ArnoudSerruys/GreenHouse/SmartGreenhouse/Smart Greenhouse.brd

## EAGLE design SmartGreenhouse/Smart Greenhouse.brd (2022-06-03)

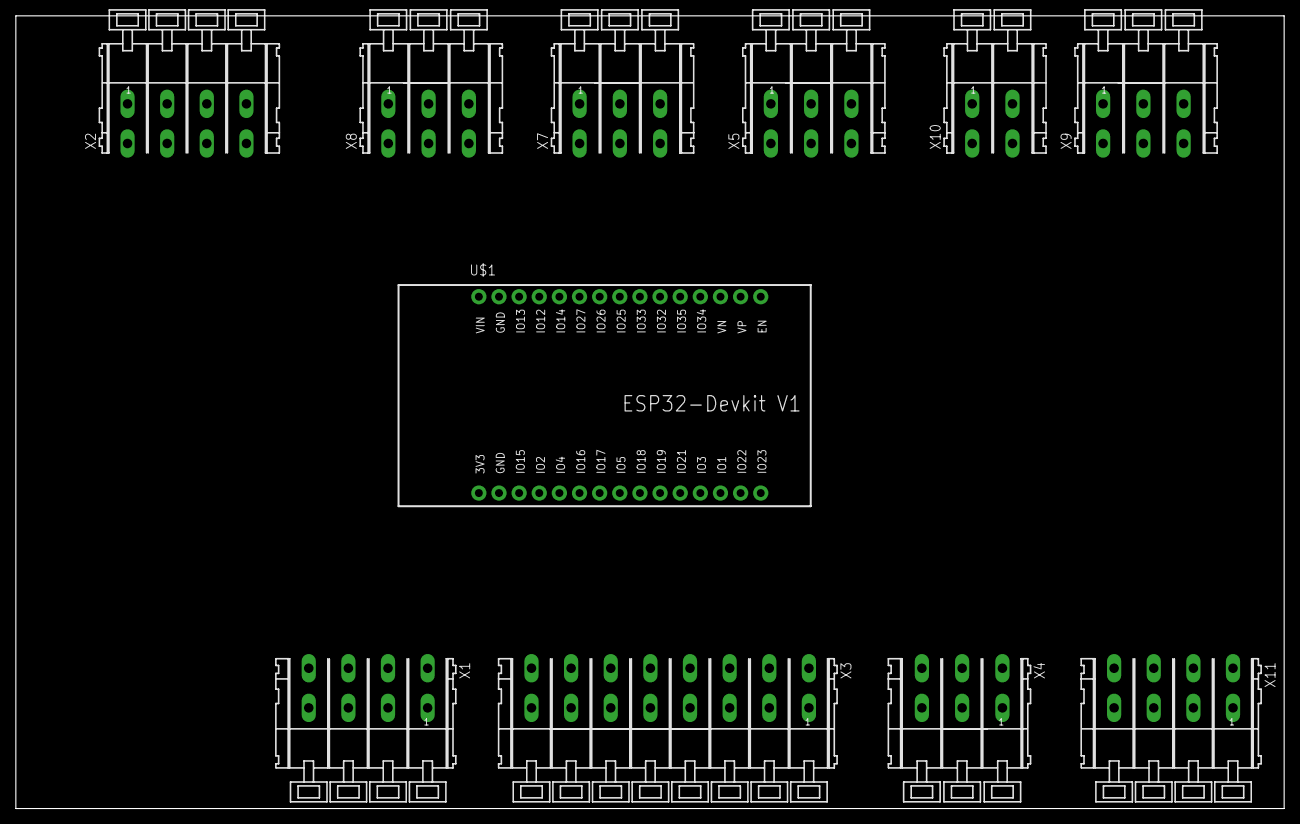
[picture p24: board Smart Greenhouse.brd from above]

Board: 2 copper layers, 160.0 x 100.0 mm, 11 parts (0 on the bottom side), 17 nets, no tracks yet.

Parts:
U$1: ESP32DEVKITV1; ESP32-DEVKITV1
X1, X2, X11: 255-404-5
X3: 255-408-5
X4, X5, X7, X8, X9: 255-403-508
X10: 255-402-508

Connections:
unnamed: U$1.28, X3.A6, X7.A1, X8.A1, X9.A1, X10.A2
unnamed: U$1.13, X1.A1
unnamed: U$1.2, X1.A4, X2.A3, X4.A1, X5.A1, X11.A4
unnamed: U$1.12, X1.A2
unnamed: U$1.30, X1.A3, X3.A8
unnamed: U$1.24, X9.A2
unnamed: U$1.24, X3.A7
unnamed: U$1.10, X3.A4
unnamed: U$1.9, X3.A3
unnamed: U$1.11, X3.A2
unnamed: U$1.22, X8.A2
unnamed: U$1.23, X7.A2
unnamed: U$1.8, X3.A1
unnamed: U$1.27, X10.A1
unnamed: U$1.4, X2.A1
unnamed: U$1.5, X11.A2
unnamed: U$1.1, X2.A4, X4.A3, X5.A3, X7.A3, X8.A3, X9.A3, X11.A1
